0bardel/SW_Mini_Fridge/Docs/Mini Fridge Drawing.pdf

100

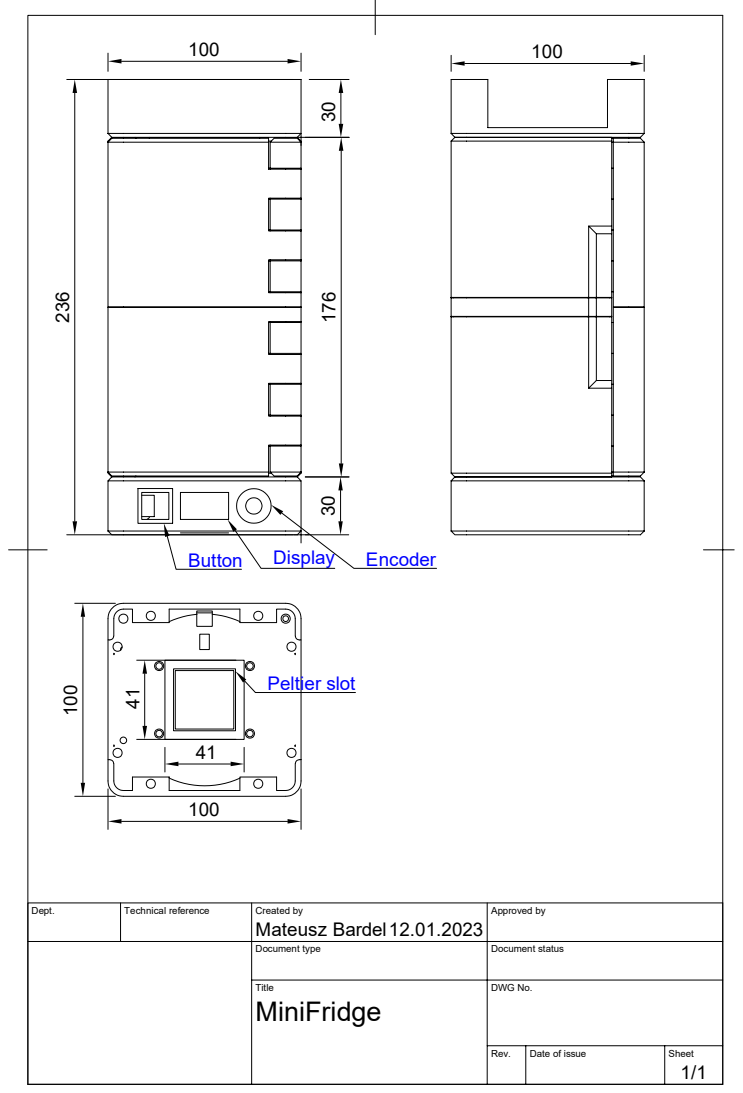
[picture p9: page 1]
Dept.; Technical reference; Created by; Approved by; Document type; Document status; Title; DWG No.; Rev.; Date of issue; Sheet; MiniFridge; 100 ¹⁰⁰; Peltier slot; Button; Display; Encoder

Mateusz Bardel ²³⁶
