0bardel/SW_Mini_Fridge/Docs/Mini Fridge Schematic.pdf

# PA7 17 PA6 16 PA5 15 PA4 14 PA3 13 PA2 12 PA1 11 PA0 10

## Display

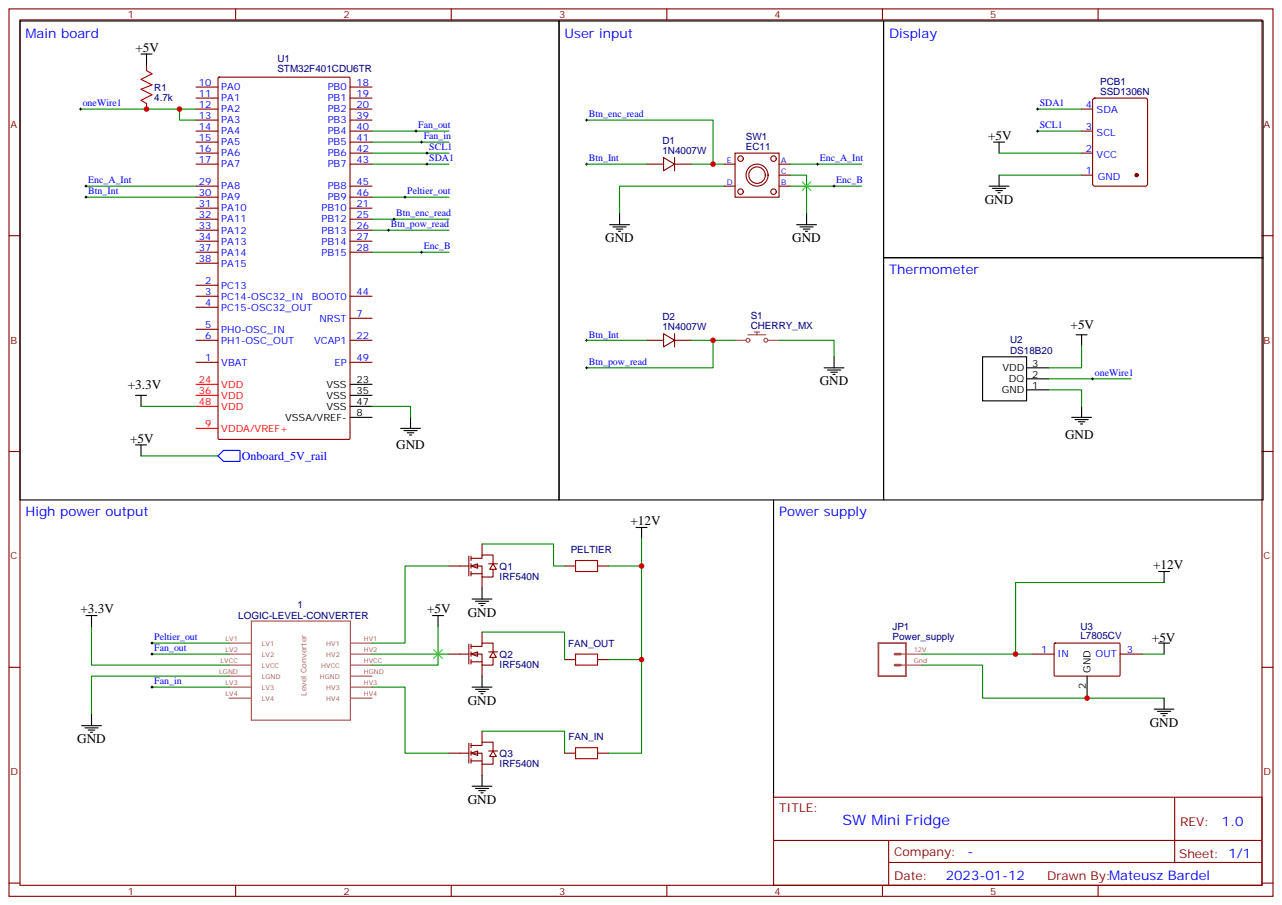
[picture p10: page 1]
