0bardel/SW_Mini_Fridge/Core/Inc/main.h

#define PELTIER_PIN GPIO_PIN_3
#define FAN_OUT_PIN GPIO_PIN_5
#define FAN_IN_PIN GPIO_PIN_4
#define BUTTON_ENCODER_PIN GPIO_PIN_12
#define BUTTON_POWER_PIN GPIO_PIN_13
#define BUTTON_INTERRUPT_TRIGGER_PIN GPIO_PIN_9
#define ENCODER_A_PIN GPIO_PIN_8
#define ENCODER_B_PIN GPIO_PIN_15
#define PELTIER_PORT GPIOB
#define FAN_OUT_PORT GPIOB
#define FAN_IN_PORT GPIOB
#define BUTTON_ENCODER_PORT GPIOB
#define BUTTON_POWER_PORT GPIOB
#define BUTTON_INTERRUPT_TRIGGER_PORT GPIOA
#define ENCODER_A_PORT GPIOA
#define ENCODER_B_PORT GPIOB
#define POWER_MAX 100
#define POWER_MIN 0
#define TEMPERATURE_MAX 200
#define TEMPERATURE_MIN -100
