0bardel/SW_Mini_Fridge/Core/Inc/menuBitmap.h

//MenuBitmap.gif
uint8_t menubitmap_data[1024] = {
	0b0,0b11111110,0b10,0b10,0b10,0b10,0b10,0b10,0b10,0b10,0b10,0b10,0b10,0b10,0b10,0b10,0b10,0b10,0b10,0b10,0b10,0b10,0b10,0b10,0b10,0b10,0b10,0b10,0b10,0b10,0b10,0b10,0b10,0b10,0b10,0b10,0b10,0b10,0b10,0b10,0b10,0b10,0b10,0b10,0b10,0b10,0b10,0b10,0b10,0b10,0b10,0b10,0b10,0b10,0b10,0b110010,0b1001010,0b1001010,0b110010,0b10,0b10,0b10,0b10,0b10,0b10,0b10,0b10,0b10,0b10,0b10,0b10,0b10,0b10,0b10,0b10,0b10,0b11111110,0b10,0b10,0b10,0b10,0b10,0b10,0b10,0b10,0b10,0b10,0b10,0b10,0b10,0b10,0b10,0b10,0b10,0b10,0b10,0b10,0b10,0b10,0b10,0b10,0b10,0b10,0b10,0b10,0b10,0b10,0b10,0b10,0b10,0b10,0b10,0b10,0b10,0b10,0b10,0b10,0b10,0b10,0b10,0b10,0b10,0b10,0b10,0b10,0b10,0b11111110,0b0,
	0b0,0b11111111,0b0,0b0,0b0,0b0,0b0,0b0,0b0,0b0,0b0,0b0,0b0,0b0,0b0,0b0,0b0,0b0,0b0,0b0,0b0,0b0,0b0,0b0,0b0,0b0,0b0,0b0,0b0,0b0,0b0,0b0,0b0,0b0,0b0,0b0,0b0,0b0,0b0,0b0,0b0,0b0,0b0,0b0,0b0,0b0,0b0,0b0,0b0,0b0,0b0,0b0,0b0,0b0,0b0,0b0,0b0,0b0,0b0,0b0,0b0,0b0,0b0,0b0,0b0,0b0,0b0,0b0,0b0,0b0,0b0,0b0,0b0,0b0,0b0,0b0,0b11111111,0b0,0b0,0b0,0b0,0b0,0b0,0b0,0b0,0b0,0b0,0b0,0b0,0b0,0b0,0b0,0b0,0b0,0b0,0b0,0b0,0b0,0b0,0b0,0b0,0b0,0b0,0b0,0b0,0b0,0b0,0b0,0b0,0b0,0b0,0b10000000,0b1000000,0b10000000,0b0,0b0,0b0,0b0,0b0,0b0,0b0,0b0,0b0,0b0,0b0,0b0,0b11111111,0b0,
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
};
