0bardel/SW_Mini_Fridge/(commit log)

2022-12-06 Added working timers
2022-12-24 Added PID, refactor, etc
2022-12-28 Tuned PID values, touch-ups.
